BaudouinS/Granulobot-Design/PCB_Design/Factory_picture/T-I16W281433A（2）.jpg

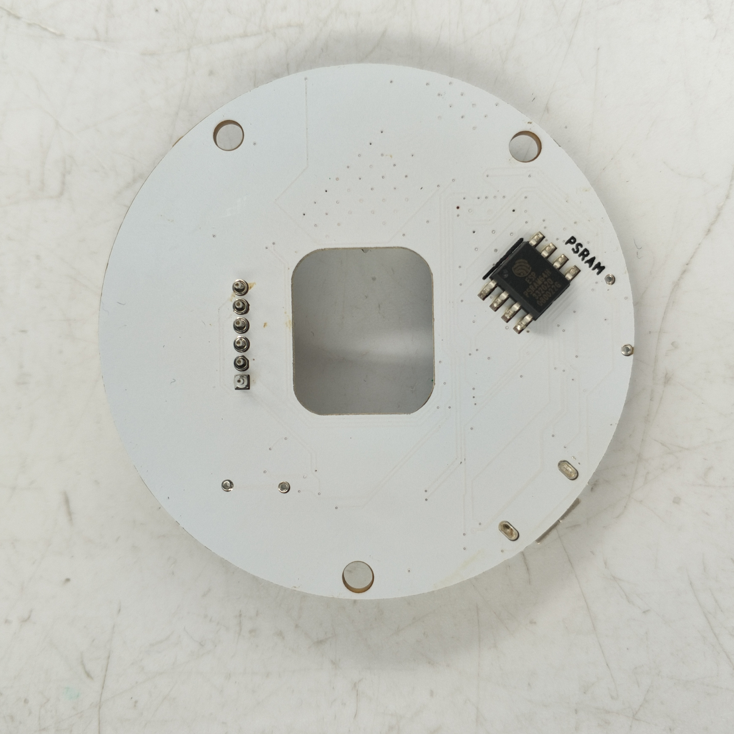
PCB_Design/Factory_picture/T-I16W281433A（2）.jpg
