BaudouinS/Granulobot-Design/PCB_Design/Factory_picture/T-I16W281433A（1）.jpg

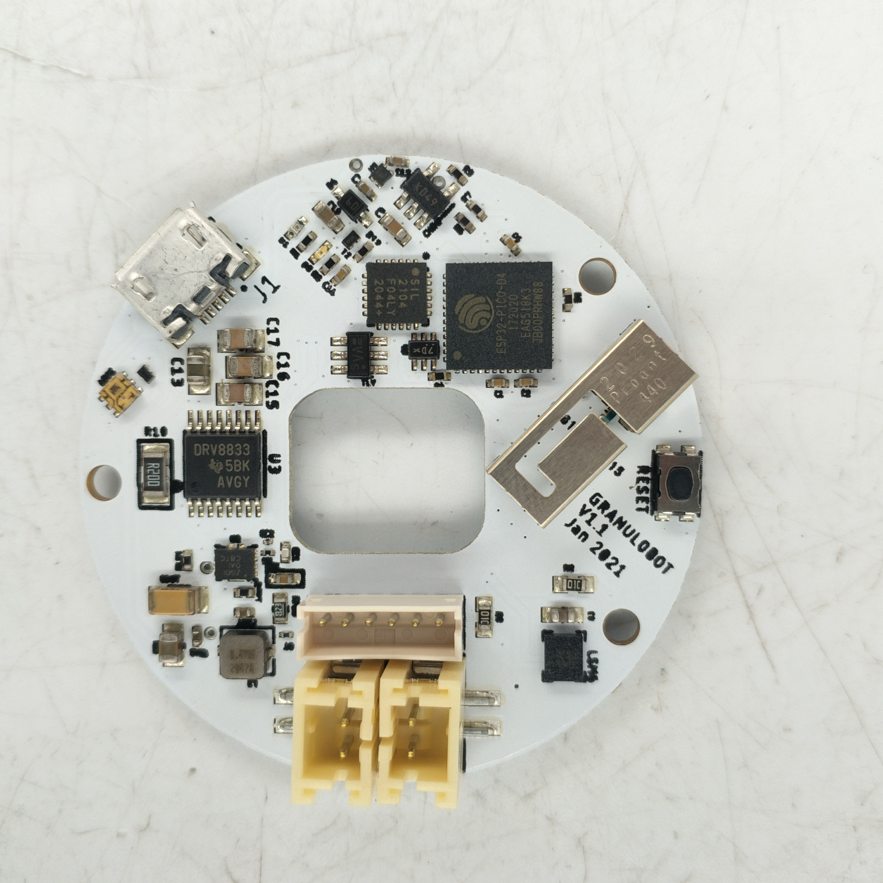
PCB_Design/Factory_picture/T-I16W281433A（1）.jpg
