BaudouinS/Granulobot-Design/PCB_Design/Copy of quotation-T-I14W281433A-W281433ASI13-10sets-Granulobot_BOM_V10_TOP 2021-1-12 _Reviewed.xls

10sets unite price | 10sets Total price | Note | Part | QTY | Manufacturer | Part Ref (manufacturer) | Package | Descritpion | Supplier | old name | Link
$0.053 | $2.100 |  | C1,C2,C6,C14 | 4 | MULTICOMP PRO | MC0402X104K250CT | 0402MP | Ceramic capacitor 0.1uF | Newark |  | https://www.newark.com/multicomp/mc0402x104k250ct/ceramic-capacitor-rohs-compliant/dp/06X6159?ost=06x6159
$0.210 | $4.200 |  | C3,C10 | 2 | SAMSUNG ELECTRO-MECHANICS | CL10A106KP8NNNC | 0603MP | Ceramic Capacitor 10UF | digikey |  | https://www.digikey.com/en/products/detail/samsung-electro-mechanics/CL10A106KP8NNNC/3886850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
$0.367 | $3.675 | 5-7work days | C4 | 1 | MURATA | GJM1555C1HR75BB01D | 0402MP | Ceramic Capacitor 0.75pF | digikey |  | https://www.digikey.com/en/products/detail/GJM1555C1HR75BB01D/490-8106-1-ND/4380393?itemSeq=347688887
$0.945 | $9.450 | 5-7work days | C5 | 1 | KEMET | C0402C159B5GACTU | 0402MP | Ceramic Capacitor 1.5pF | digikey |  | https://www.digikey.com/en/products/detail/kemet/C0402C159B5GACTU/3316947
$0.053 | $1.050 |  | C7,C12 | 2 | MURATA | GRT155R70J105KE01D | 0402MP | Ceramic capacitor 1uF | digikey |  | https://www.digikey.com/en/products/detail/GRT155R70J105KE01D/490-18216-1-ND/9867945?itemSeq=347689425
$0.053 | $0.525 |  | C8 | 1 | MULTICOMP PRO | MCSH18B104K250CT | 0603-NO | Ceramic capacitor 0.1uF | newark |  | https://www.newark.com/multicomp/mcsh18b104k250ct/ceramic-capacitor-rohs-compliant/dp/23T7348?ost=23t7348
$0.105 | $1.050 |  | C13 | 1 | TAIYO YUDEN | LMK212BJ106KG-T | 0805-NO | Ceramic Capacitor 10UF | digikey |  | https://www.digikey.com/en/products/detail/taiyo-yuden/LMK212BJ106KG-T/930652
$0.053 | $0.525 |  | C15 | 1 | MULTICOMP PRO | MCSH21B104K100CT | 0805-NO | Ceramic capacitor 0.1uF | newark |  | https://www.newark.com/multicomp/mcsh21b104k100ct/ceramic-capacitor-rohs-compliant/dp/23T7403?ost=23t7403
$0.210 | $4.200 |  | C16,C17 | 2 | YAGEO | CC0805KKX5R8BB106 | 0805-NO | Ceramic Capacitor 10UF | digikey |  | https://www.digikey.com/en/products/detail/yageo/CC0805KKX5R8BB106/5195275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
$0.053 | $0.525 |  | Cbst | 1 | MuRata | GRM155R71A104KA01D | 0402_ | Ceramic capacitor 0.1uF | digikey
$0.032 | $0.315 |  | Cc1 | 1 | MuRata | GRM1555C1H391JA01J | 0402_ | Ceramic capacitor 390pF | digikey
$0.630 | $6.300 | 5-7work days | Cc2 | 1 | TDK | C0402C0G1C180J020BC | 01005_ | Ceramic capacitor 18 pF | digikey
$0.210 | $2.100 | paramters is 22uF OK | Cin | 1 | MuRata | GRM21BR61A226ME44L | 0805_ | Ceramic capacitor 12uF | digikey
$0.053 | $0.525 |  | Cin2 | 1 | MuRata | GRM155R71C104KA88D | 0402_ | Ceramic capacitor 0.1uF | digikey
$0.525 | $5.250 |  | Cout | 1 | TDK | C3216X5R1E476M160AC | 1206_ | Ceramic capacitor 47 uF | digikey
$0.105 | $1.050 | out of stock, we suggest is GRM155R61A475MEAAD, is it OK? OK | Cvcc | 1 | MuRata | GRJ155R61A475ME1J | 0402_ | Ceramic capacitor 4.7 uF | Mouser
$0.032 | $0.630 |  | R1,R8 | 2 | PANASONIC | ERJ-2RKF2001X | _0402MP | RESISTOR 2K | digikey |  | https://www.digikey.com/en/products/detail/panasonic-electronic-components/ERJ-2RKF2001X/192194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
$0.032 | $0.630 | out of stock, we suggest is RC0603FR-0710KL, is it OK? OK | R2,R9 | 2 | NIC COMPONENTS | NRC-AS06F1002TRF | R0603 | RESISTOR 10K | newark |  | https://www.newark.com/nic-components/nrc-as06f1002trf/res-10k-1-0-1w-0603-thick-film/dp/52AH2942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
$0.032 | $0.315 |  | R3 | 1 | PANASONIC | ERJ-2RKF3301X | _0402MP | RESISTOR 3K3 | newark |  | https://www.newark.com/panasonic/erj-2rkf3301x/res-thick-film-3k3-1-0-1w-0402/dp/64R5278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
$0.032 | $0.315 |  | R4 | 1 | PANASONIC | ERJ-2RKF1002X | _0402MP | RESISTOR 10K | newark |  | https://www.newark.com/panasonic/erj-2rkf1002x/res-thick-film-10k-1-0-1w-0402/dp/64R5248?ost=erj-2rkf1002x
$0.032 | $0.630 |  | R5,R11 | 2 | MULTICOMP PRO | MCWR04X1003FTL | _0402MP | RESISTOR 100K | newark |  | https://www.newark.com/multicomp-pro/mcwr04x1003ftl/res-100k-1-62-5mw-0402-thick-film/dp/94X1105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
$0.032 | $0.315 |  | R6 | 1 | PANASONIC | ERJ-2RKF4423X | _0402MP | RESISTOR 442K | digikey |  | https://www.digikey.com/en/products/detail/panasonic-electronic-components/ERJ-2RKF4423X/192365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
$0.032 | $0.315 |  | R7 | 1 | VISHAY | CRCW0402160KFKED | _0402MP | RESISTOR 160K | newark |  | https://www.newark.com/vishay/crcw0402160kfked/res-thick-film-160k-1-0-063w-0402/dp/89M6611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
$0.525 | $5.250 | 5-7work days | R10 | 1 | OHMITE | KDV12FR200ET | _1206 | RESISTOR 0.2R 0.2ohm | newark |  | https://www.newark.com/ohmite/kdv12fr200et/0-2-ohm-1206-1-0-5w-rohs-compliant/dp/29AH2849?ost=kdv12fr200et
$0.032 | $0.315 |  | RC1 | 1 | Yageo | RC0201FR0723K7L | R0201 | RESISTOR 23.7k | digikey |  | https://www.digikey.com/en/products/detail/yageo/RC0201FR-0723K7L/5280384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
$0.032 | $0.315 |  | Rfbb | 1 | Yageo | RC0603FR-0782KL | R0603 | RESISTOR 82 k | digikey
$0.032 | $0.315 |  | Rfbt | 1 | Vishay-Dale | CRCW0402324KFKED | R0402 | RESISTOR 324 k | digikey
$0.032 | $0.315 |  | Rlim | 1 | Vishay-Dale | CRCW0402187KFKED | R0402 | RESISTOR 187 k | Mouser
$0.945 | $9.450 | 5-7work days | Rt | 1 | Vishay-Dale | CRCW020168K1FKED | R0201 | RESISTOR 68.1 k | Mouser
$0.840 | $8.400 | 5-7work days | D1 | 1 | WURTH ELEKTRONIK | 150040SS73220 | _0402 | LED red | digikey |  | https://www.digikey.com/en/products/detail/w%C3%BCrth-elektronik/150040SS73220/9857944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
$0.630 | $6.300 | 5-7work days | D2 | 1 | DIALIGHT | 5988A30107F | _0402 | LED Orange | digikey | D3 | https://www.digikey.com/en/products/detail/dialight/5988A30107F/10108964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
$0.210 | $2.100 |  | D3 | 1 | STMICROELECTRONICS | BAT60JFILM | SOD323_ST | Schottky barrier diode | eBay | D4
$7.665 | $7.665 | 3341 1pack-10pcs=$7.665 5-7work days | D4 | 1 | ADAFRUIT | _3341 | AP102-2020 | APA-102 RGB LED | digikey | LED1 | https://www.digikey.com/en/products/detail/adafruit-industries-llc/3341/6578337
$2.100 | $21.000 | 0402DC-7N5XGRW 5-7work days OK | L1 | 1 | COILCRAFT | 0402DC-7N5XGRW | 0402_N | INDUCTOR 7.5nH High Q at 2.4GHz (for Wifi antenna) | digikey |  | https://www.digikey.com/en/products/detail/coilcraft/0402DC-7N5XGRW/12714785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
$1.575 | $15.750 | 5-7work days | L2 | 1 | Vishay-Dale | IHLP1212AEERR47M11 |  | INDUCTOR 470nH DCR: 15 mΩ IDC: 6.7 A | digikey |  | https://www.digikey.com/en/products/detail/vishay-dale/IHLP1212AEERR47M11/2533925
$0.315 | $3.150 | 5-7work days | T1 | 1 | Nexperia | PDTA143TMB,315 | SOT883(B) | PNP general purpose transistors | Mouser | PDTA143TMB,315 | https://www.mouser.com/ProductDetail/Nexperia/PDTA143TMB315
$0.420 | $4.200 | 5-7work days | T2 | 1 | ON Semiconductor | NTNS3A65PZT5G | SOT883 | MOSFET P-CH 20V 281MA | digikey |  | https://www.digikey.com/en/products/detail/on-semiconductor/NTNS3A65PZT5G/4848843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
$0.210 | $2.100 |  | T3 | 1 | ON SEMICONDUCTOR | MUN5214DW1T1G | SOT-363 | DUAL NPN transistor SC70-6 | newark | Q3 | https://www.newark.com/on-semiconductor/mun5214dw1t1g/brt-transistor-50v-47k-10kohm/dp/10N9540
$0.525 | $5.250 | 5-7work days | U1 | 1 | ON SEMICONDUCTOR | NCP167BMX330TBG | 4-XDFN | LDO 700 MA ULTRA-LOW NOI | digikey |  | https://www.digikey.com/en/products/detail/on-semiconductor/NCP167BMX330TBG/9169761
$1.575 | $15.750 |  | U2 | 1 | Texas Instruments | TPS61089RNRR | VQFN | 12.6-V, 7-A Fully-Integrated Synchronous Boost Converters | Texas Instrument |  | https://www.ti.com/store/ti/en/p/product/?p=TPS61089RNRR
$1.050 | $10.500 |  | U3 | 1 | Texas Instruments | DRV8833PWPR | 16-HTSSOP | IC MOTOR DRIVER PAR 16HTSSOP | Texas Instrument |  | https://www.ti.com/store/ti/en/p/product/?p=DRV8833PWPR
$1.575 | $15.750 |  | U4 | 1 | SILICON LABS | CP2104-F03-GMR | 24QFN | USB TO SERIAL CONVERTER MICROBUILDER | digikey | IC2 | https://www.digikey.com/en/products/detail/CP2104-F03-GMR/336-4146-1-ND/7650425?itemSeq=346297763
$0.735 | $7.350 |  | CHRG | 1 | Microchip Technology | MCP73831T-2ACI/OT | SOT23-5 | IC BATT CNTL LI-ION 1CEL | digikey |  | https://www.digikey.com/en/products/detail/microchip-technology/MCP73831T-2ACI-OT/964301
$6.153 | $61.530 | 3-4work days OK | LSM6 | 1 | STMicroelectronics | LSM6DSOXTR | 14-VFLGA | INEMO INERTIAL MODULE: 3D ACCELE | Mouser | ISM330 | https://www.mouser.com/ProductDetail/511-LSM6DSOXTR
$4.200 | $42.000 |  | ESP32 | 1 | Espressif Systems | ESP32-PICO-D4 | QFN-48 | ESP32-PICO-D4 | Mouser | PICO-D4 | https://www.mouser.com/ProductDetail/Espressif-Systems/ESP32-PICO-D4/?qs=MLItCLRbWsw7MJlbN3HfdA%3D%3D
$1.785 | $17.850 | SUGGEST IS TLV493DA1B6HTSA2 5-7work days, is it OK? OK | TLV | 1 | Infineon Technologies | TLV493DA1B6HTSA2 | TSOP-6 | Board Mount Hall Effect / Magnetic Sensors | Mouser | TLV493D | https://www.mouser.com/ProductDetail/Infineon-Technologies/TLV493DA1B6HTSA2/
$0.525 | $5.250 |  | J1 | 1 | Amphenol ICC (FCI) | 10118193-0001LF |  | USB - micro B USB 2.0 Receptacle Connector 5 Position Surface Mount, Right Angle; Through Hole | digikey |  | https://www.digikey.com/en/products/detail/amphenol-icc-fci/10118193-0001LF/2785388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
$0.420 | $4.200 | 5-7work days | J2 | 1 | JST | B6B-ZR(LF)(SN) | ZR | ZR Series 1.5 mm Pitch 6 Position Through Hole Top Entry Shrouded Heade Check prices | digikey |  | https://www.digikey.com/en/products/detail/amphenol-icc-fci/10118193-0001LF/2785388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
$0.315 | $6.300 | we provide is B2B-PH-SM4-TB(LF)(SN), is it OK? OK | J3, J4 | 2 | JST | B2B-PH-SM4-TB(LF)(SN) | PH | B2B-PH-SM4-TB | newark | LIPO-CON-1,LIPO-CON-2 | https://www.newark.com/jst-japan-solderless-terminals/b2b-ph-sm4-tb-lf-sn/wire-to-board-connector-header/dp/37K9941
$0.840 | $8.400 | 7-10work days | KMR2 | 1 | C & K COMPONENTS | KMR241NG ULC LFS | BTN_KMR2_4.6X2.8 | Push button (Reset ) | newark |  | https://www.newark.com/c-k-components/kmr241ng-ulc-lfs/tact/dp/35AH0932?st=kmr241ng
$0.892 | $8.925 | 5-7work days | ANT | 1 | Proant AB | PRO-OB-440 |  | RF ANT 2.4GHZ STAMPED MET SLD | digikey |  | https://www.digikey.com/en/products/detail/proant-ab/PRO-OB-440/4895679?s=N4IgTCBcDaIA4CcD2BaJAjFAWLAGEAugL5A
$1.575 | $15.750 |  | PSRAM | 1 | espressif | ESP-PSRAM64H | SOP8 | Extra memory - facultative -64M Bits Serial Pseudo-SRAM with SPI and QPI | eBay
 | $357.420 | component price
 | $88.000 | assembly price | Total Items | 62
 | $130.000 | board price
