BaudouinS/Granulobot-Design/Mechanical_Design/Passive_Rotor_V20_M15.STL

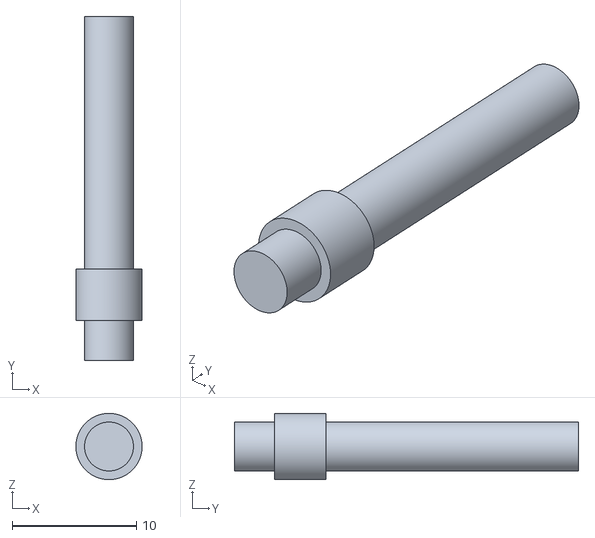
[picture p3: CAD file, 2023-03-20]
Mechanical_Design/Passive_Rotor_V20_M15.STL
5.33 x 27.7 x 5.33
