BaudouinS/Granulobot-Design/PCB_Design/Granulobot_V9_top.dxf

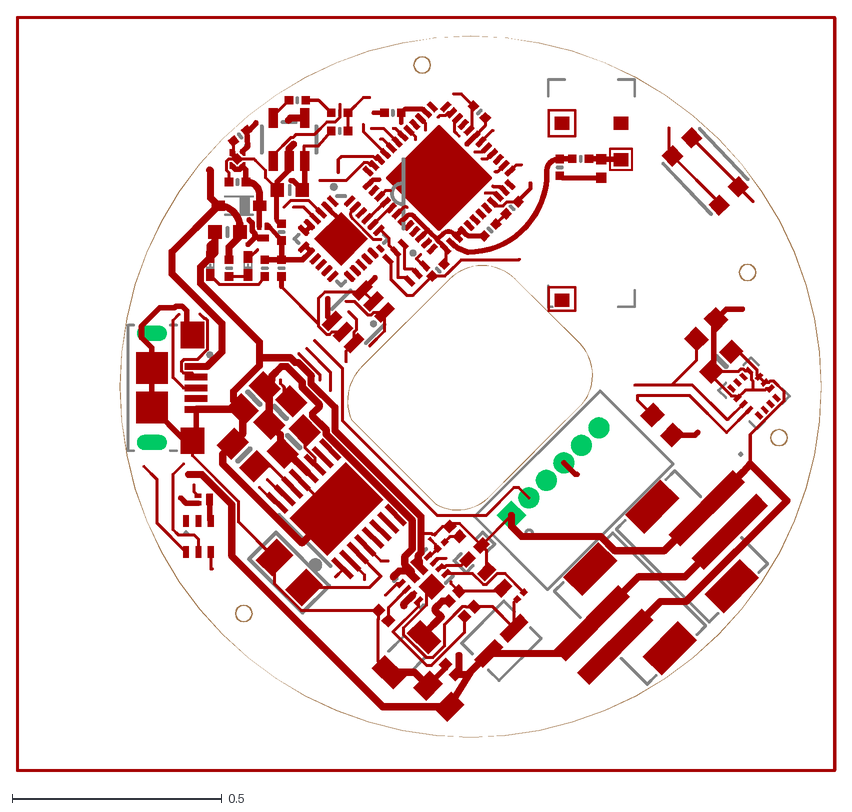
[picture p4: CAD file, 2023-02-26]
PCB_Design/Granulobot_V9_top.dxf
1.95 x 1.80
