BaudouinS/Granulobot-Design/Mechanical_Design/Bearing_lower_centering_V20.STL

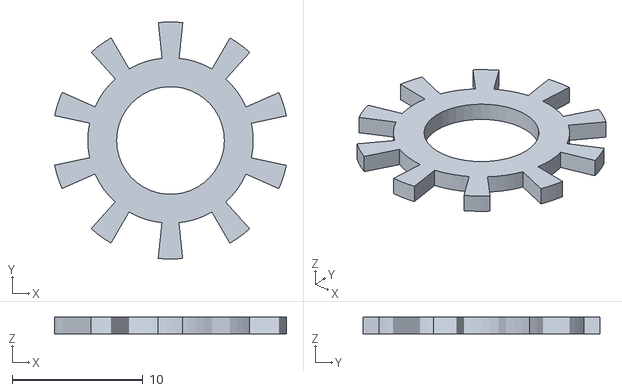
[picture p5: CAD file, 2023-03-20]
Mechanical_Design/Bearing_lower_centering_V20.STL
17.8 x 18.2 x 1.27
