BaudouinS/Granulobot-Design/Mechanical_Design/Balls_Holder_12slots_V20.STL

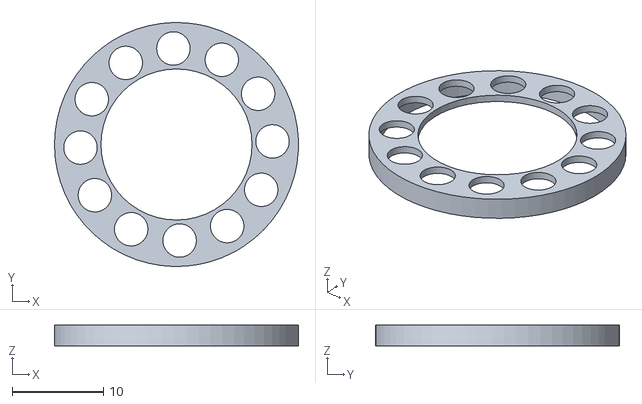
[picture p6: CAD file, 2023-03-20]
Mechanical_Design/Balls_Holder_12slots_V20.STL
26.7 x 26.7 x 2.29
