BaudouinS/Granulobot-Design/Mechanical_Design/Active_Rotor_V20_upperwheel.STL

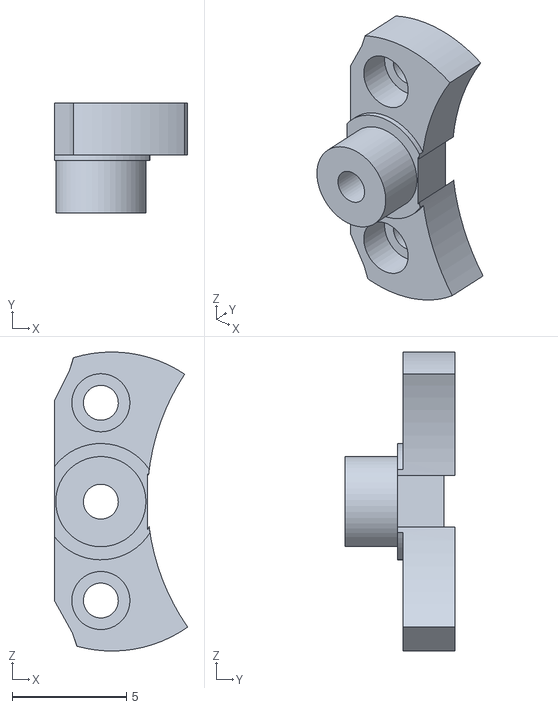
[picture p7: CAD file, 2023-03-20]
Mechanical_Design/Active_Rotor_V20_upperwheel.STL
5.82 x 4.80 x 13.1
