BaudouinS/Granulobot-Design/Mechanical_Design/Battery_Holder_V20_2Batt.STL

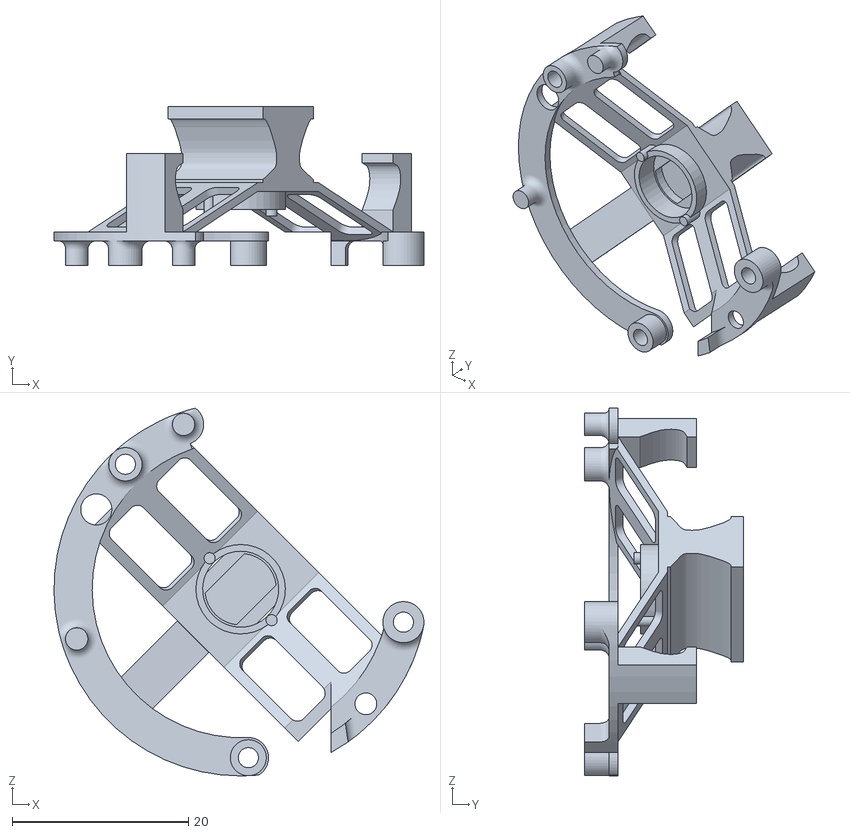
[picture p8: CAD file, 2023-03-20]
Mechanical_Design/Battery_Holder_V20_2Batt.STL
42.0 x 18.0 x 41.8
