BaudouinS/Granulobot-Design/Mechanical_Design/adjustment_ring_V20.STL

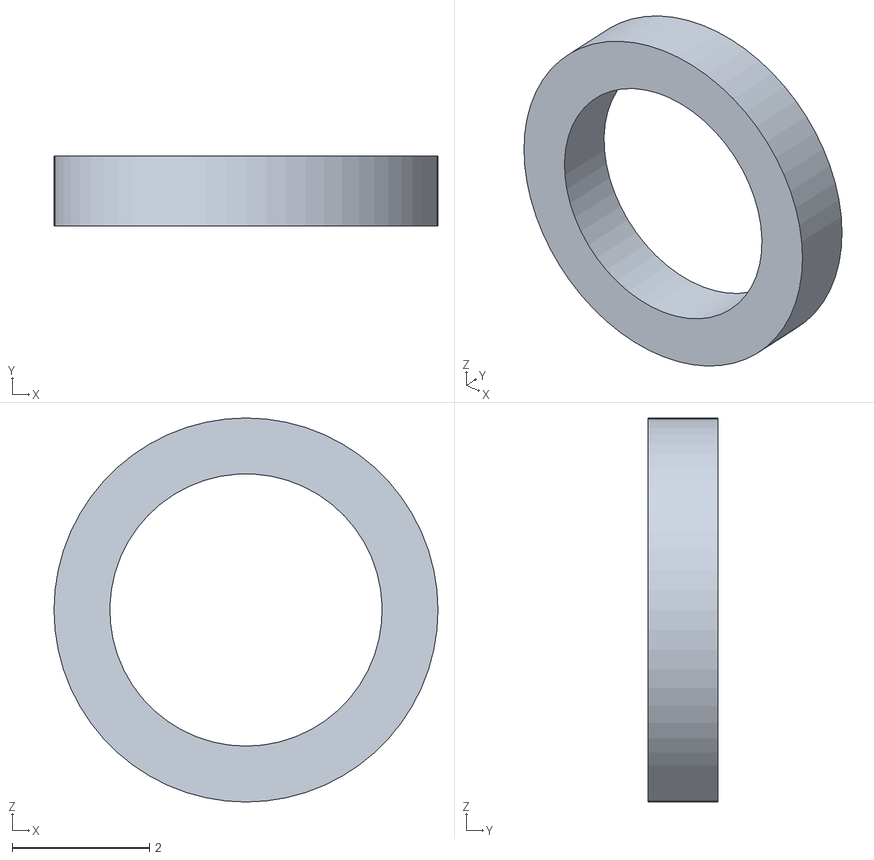
[picture p9: CAD file, 2023-03-20]
Mechanical_Design/adjustment_ring_V20.STL
5.59 x 1.02 x 5.59
