BaudouinS/Granulobot-Design/Mechanical_Design/MagnetRod_sleeve_V20_M15.STL

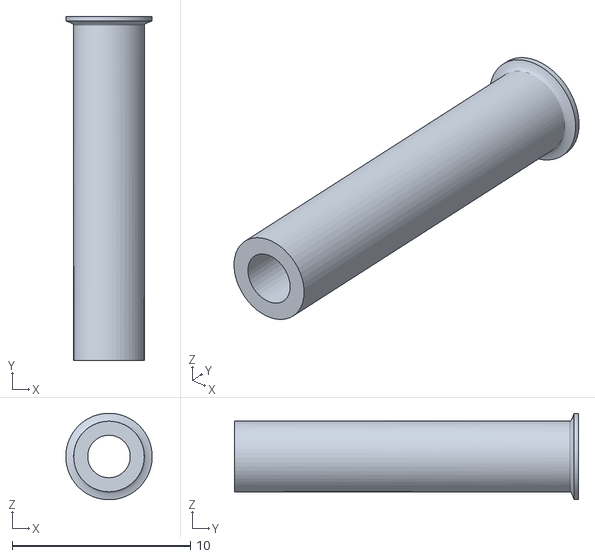
[picture p10: CAD file, 2023-03-20]
Mechanical_Design/MagnetRod_sleeve_V20_M15.STL
4.85 x 19.3 x 4.85
