BaudouinS/Granulobot-Design/Mechanical_Design/Bearing-attach-V20_4.STL

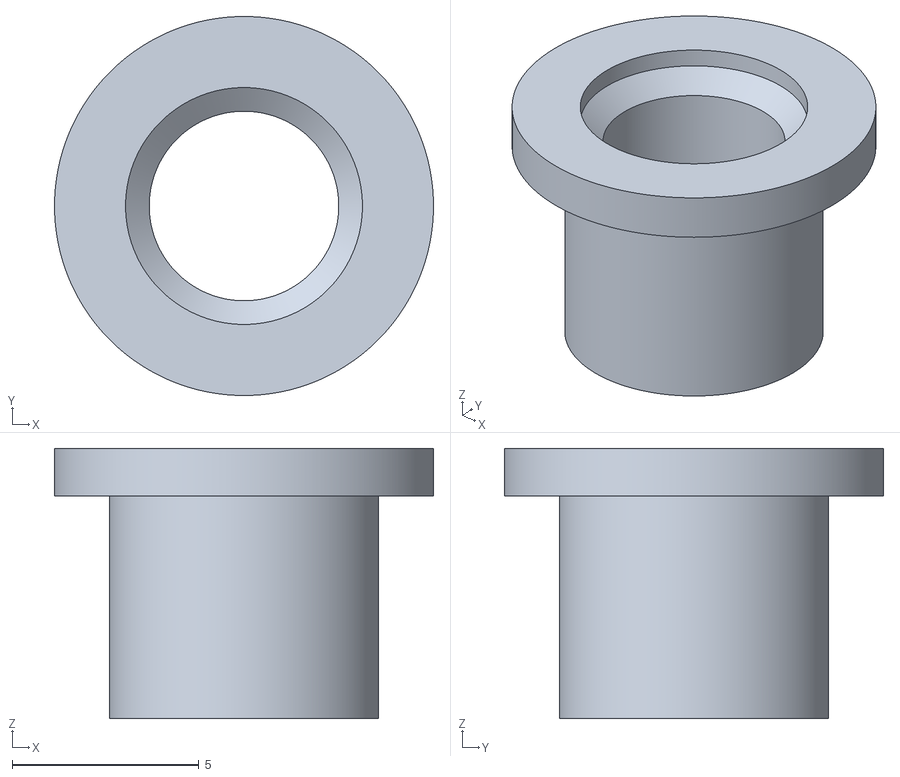
[picture p11: CAD file, 2023-03-20]
Mechanical_Design/Bearing-attach-V20_4.STL
10.2 x 10.2 x 7.24
