BaudouinS/Granulobot-Design/Mechanical_Design/Lower-Motor_gear_V20_gear-wave_1.STL

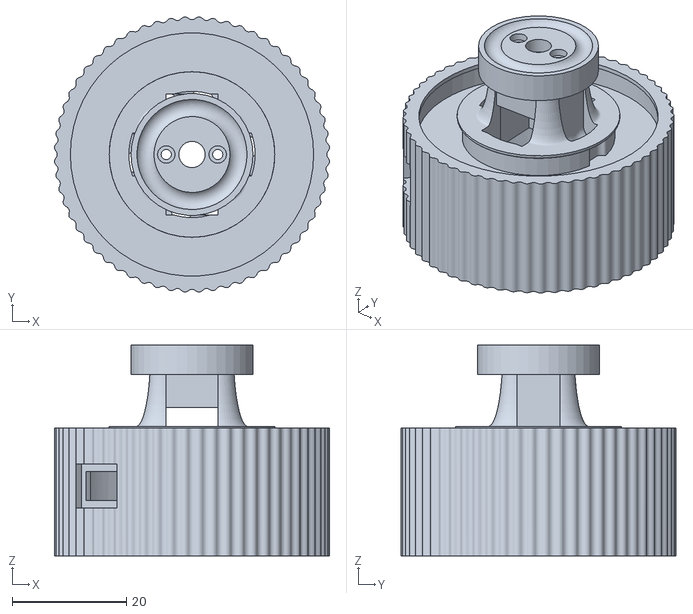
[picture p12: CAD file, 2023-03-20]
Mechanical_Design/Lower-Motor_gear_V20_gear-wave_1.STL
48.1 x 48.1 x 36.8
