BaudouinS/Granulobot-Design/Mechanical_Design/Nut_ShaftTightScrew_V20.STL

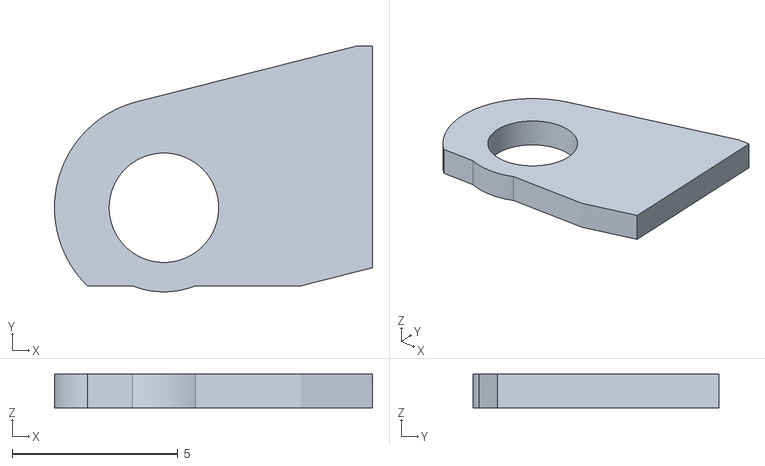
[picture p13: CAD file, 2023-03-20]
Mechanical_Design/Nut_ShaftTightScrew_V20.STL
9.60 x 7.42 x 1.02
