BaudouinS/Granulobot-Design/PCB_Design/Granulobot_V10.brd

## EAGLE design PCB_Design/Granulobot_V10.brd (2023-02-26)

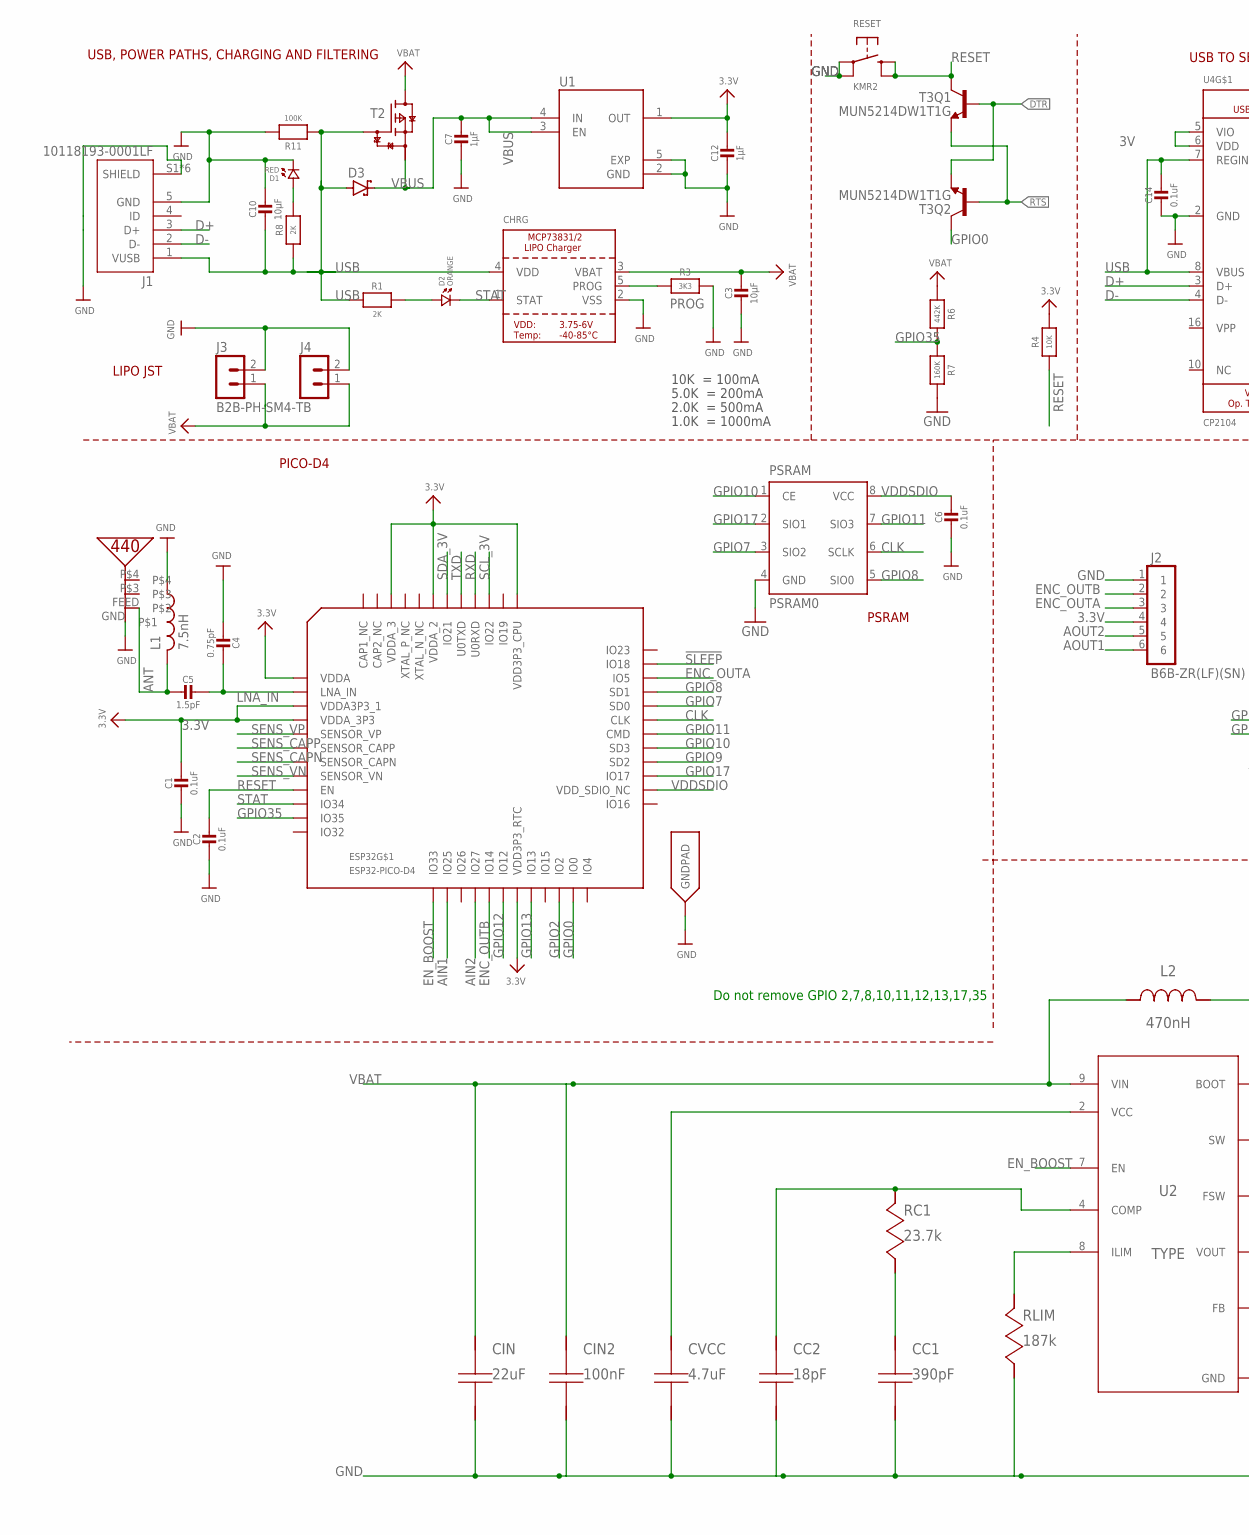
[picture p14: schematic Granulobot_V10.sch, part in row 1, column 1]

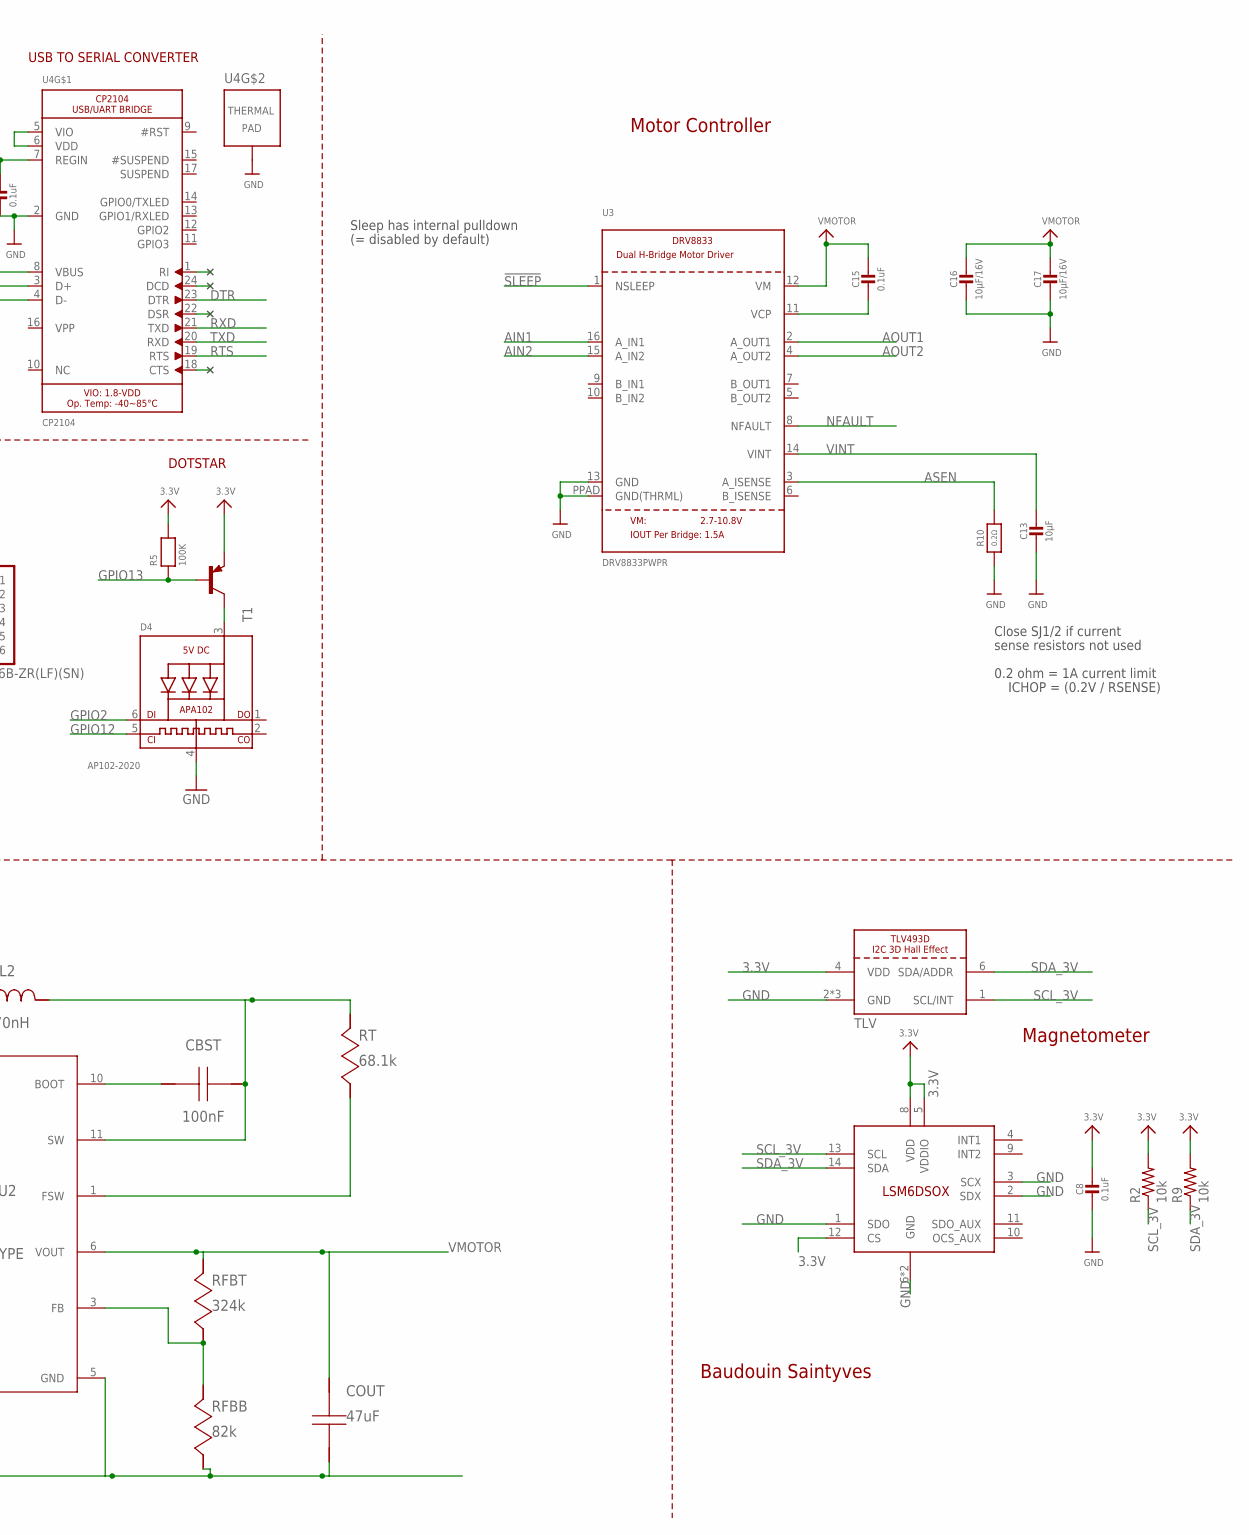
[picture p15: schematic Granulobot_V10.sch, part in row 1, column 2]

Parts:
ANT: PRO-OB-440
C1, C2, C6, C14: 0.1uF; _0402MP; MPN MC0402X104K250CT
C3, C10: 10µF; _0603MP; MPN CL10A106KP8NNNC
C4: 0.75pF; _0402MP; MPN GJM1555C1HR75BB01D
C5: 1.5pF; _0402MP; MPN C1005C0G1H1R5B050BA
C7, C12: 1µF; _0402MP; MPN GRT155R70J105KE01D.
C8: 0.1uF; 0603-NO; MPN MCSH18B104K250CT
C13: 10µF; 0805-NO; MPN LMK212BJ106KG-T
C15: 0.1uF; 0805-NO; MPN MCSH21B104K100CT
C16, C17: 10µF/16V; 0805-NO; MPN CC0805KKX5R8BB106
CBST: 100nF; 0402; MPN MC0402X104K250CT
CC1: 390pF; 0402; MPN MC0402B391K250CT
CC2: 18pF; 01005; MPN GRM0225C1E180GA02L
CHRG: TP4065-4.2V-SOT25-R; SOT23-5
CIN: 22uF; 0805; MPN C1210C224J3GACTU
CIN2: 100nF; 0402; MPN MC0402X104K250CT
COUT: 47uF; 1206; MPN C0603C474K4PACTU
CVCC: 4.7uF; 0402_065; MPN JMK105BBJ475MV-F
D1: RED; 0402.LED; MPN 150040SS73220
D2: ORANGE; 0402.LED; MPN 5988A30107F
D3: BAT60J; SOD323_ST; MPN BAT60JFILM
D4: AP102-2020; MICROBUILDER_APA102_2020
ESP32: ESP32-PICO-D4; PICO-D4-QFN48
J1: 10118193-0001LF; FCI_10118193-0001LF
J2: B6B-ZR(LF)(SN); JST_B6B-ZR(LF)(SN)
J3, J4: B2B-PH-SM4-TB; MPN B2B-PH-SM4-TB(LF)(SN)
L1: 7.5nH; RESC0402_N; MPN ELJ-QF7N5JF
L2: 470nH; IHLP-1212AE; MPN IHLP1212AEERR47M11
LSM6: LSM6DSOX; LGA-14L
PSRAM: PSRAM0; SOP8
R1, R8: 2K; _0402MP; MPN ERJ-2RKF2001X
R2, R9: 10k; R0603; MPN NRC-AS06F1002TRF
R3: 3K3; _0402MP; MPN ERJ-2RKF3301X
R4: 10K; _0402MP; MPN ERJ-2RKF1002X
R5, R11: 100K; _0402MP; MPN MCWR04X1003FTL
R6: 442K; _0402MP; MPN ERJ-2RKF4423X
R7: 160K; _0402MP; MPN CRCW0402160KFKED
R10: 0.2Ω; _1206; MPN KDV12FR200ET
RC1: 23.7k; 0201
RESET: KMR2; BTN_KMR2_4.6X2.8; MPN KMR231G LFS
RFBB: 82k; 0603; MPN NRC-AS06F8202TRF
RFBT: 324k; 0402; MPN ERJ-2RKF3243X
RLIM: 187k; 0402; MPN ERJ-2RKF1873X
RT: 68.1k; 0201; MPN RC0201FR-0768K1L
T1: TINYPICO-PNPAMB; SOT883(B)
T2: TINYPICO-P-FETKMB; SOT883(B)
T3: MUN5214DW1T1G; DUAL_NPN_SC70-6; MPN MUN5214DW1T1G
TLV: TLV493D; SOT23-6; MPN TLV493DA1B6HTSA2
U1: NCP170AMX300TCG; VREG_NCP170AMX300TCG; MPN NCP170AMX300TCG
U2: Value; RNR0011A
U3: DRV8833PWPR; HTSSOP16; MPN DRV8833PWPR
U4: CP2104; MICROBUILDER_QFN24_4MM_SMSC; MPN CP2104-F03-GMR

Connections:
3.3V: C1.1, C8.1, C12.1, ESP32.1 (VDDA), ESP32.3 (VDDA3P3_1), ESP32.4 (VDDA_3P3), ESP32.19 (VDD3P3_RTC), ESP32.37 (VDD3P3_CPU), ESP32.43 (VDDA_2), ESP32.46 (VDDA_3), J2.4, LSM6.5 (VDDIO), LSM6.8 (VDD), LSM6.12 (CS), R2.2, R4.2, R5.2, R9.2, T1.2 (E), TLV.4 (VDD), U1.1 (OUT)
3V: U4.5 (VIO), U4.6 (VDD)
!SLEEP: ESP32.35 (IO18), U3.1 (NSLEEP)
AIN1: ESP32.14 (IO25), U3.16 (A_IN1)
AIN2: ESP32.16 (IO27), U3.15 (A_IN2)
ANT: ANT.FEED, C5.2, L1.2
AOUT1: J2.6, U3.2 (A_OUT1)
AOUT2: J2.5, U3.4 (A_OUT2)
ASEN: R10.2, U3.3 (A_ISENSE)
CLK: ESP32.31 (CLK), PSRAM.6 (SCLK)
D+: J1.3 (D+), U4.3 (D+)
D-: J1.2 (D-), U4.4 (D-)
DTR: T3.1 (E), T3.5 (B), U4.23 (DTR)
ENC_OUTA: ESP32.34 (IO5), J2.3
ENC_OUTB: ESP32.17 (IO14), J2.2
EN_BOOST: ESP32.13 (IO33), U2.7 (EN)
GND: ANT.GND, C1.2, C2.2, C3.2, C4.2, C6.2, C7.2, C8.2, C10.1, C12.2, C13.2, C14.2, C16.2, C17.2, CC1.2, CC2.2, CHRG.2 (VSS), CIN.2, CIN2.2, COUT.2, CVCC.2, D1.P$2 (2), D4.4 (GND), ESP32.EXP (GNDPAD), J1.5 (GND), J1.S1 (SHIELD), J1.S2 (SHIELD), J1.S3 (SHIELD), J1.S4 (SHIELD), J1.S5 (SHIELD), J1.S6 (SHIELD), J2.1, J3.2, J4.2, L1.1, LSM6.1 (SDO), LSM6.2 (SDX), LSM6.3 (SCX), LSM6.6 (GND), LSM6.7 (GND), PSRAM.4 (GND), R3.2, R7.2, R10.1, R11.2, RESET.A, RESET.A' (P1), RFBB.2, RLIM.2, TLV.2 (GND), TLV.3 (GND), TLV.5 (GND), U1.2 (GND), U1.5 (EXP), U2.5 (GND), U3.13 (GND), U3.PPAD (GND(THRML)), U4.2 (GND), U4.THERM (TP)
GPIO0: ESP32.23 (IO0), T3.6 (C)
GPIO2: D4.6 (DI), ESP32.22 (IO2)
GPIO7: ESP32.32 (SD0), PSRAM.3 (SIO2)
GPIO8: ESP32.33 (SD1), PSRAM.5 (SIO0)
GPIO9: ESP32.28 (SD2)
GPIO10: ESP32.29 (SD3), PSRAM.1 (CE)
GPIO11: ESP32.30 (CMD), PSRAM.7 (SIO3)
GPIO12: D4.5 (CKI), ESP32.18 (IO12)
GPIO13: ESP32.20 (IO13), R5.1, T1.1 (B)
GPIO17: ESP32.27 (IO17), PSRAM.2 (SIO1)
GPIO35: ESP32.11 (IO35), R6.2, R7.1
LNA_IN: C4.1, C5.1, ESP32.2 (LNA_IN)
unnamed: D1.P$1 (1), R8.2
unnamed: D2.P$1 (1), R1.2
unnamed: D4.3 (VDD), T1.3 (C)
unnamed: C15.2, U3.11 (VCP)
unnamed: RFBB.1, RFBT.2, U2.3 (FB)
unnamed: RLIM.1, U2.8 (ILIM)
unnamed: CBST.1, U2.10 (BOOT)
unnamed: CBST.2, L2.2, RT.1, U2.11 (SW)
unnamed: CVCC.1, U2.2 (VCC)
unnamed: CC1.1, RC1.2
unnamed: CC2.1, RC1.1, U2.4 (COMP)
unnamed: RT.2, U2.1 (FSW)
NFAULT: U3.8 (NFAULT)
PROG: CHRG.5 (PROG), R3.1
RESET: C2.1, ESP32.9 (EN), R4.1, RESET.B (S), RESET.B' (S1), T3.3 (C)
RTS: T3.2 (B), T3.4 (E), U4.19 (RTS)
RXD: ESP32.40 (U0RXD), U4.21 (TXD)
SCL_3V: ESP32.39 (IO22), LSM6.13 (SCL), R2.1, TLV.1 (SCL/INT)
SDA_3V: ESP32.42 (IO21), LSM6.14 (SDA), R9.1, TLV.6 (SDA/ADDR)
SENS_CAPN: ESP32.7 (SENSOR_CAPN)
SENS_CAPP: ESP32.6 (SENSOR_CAPP)
SENS_VN: ESP32.8 (SENSOR_VN)
SENS_VP: ESP32.5 (SENSOR_VP)
STAT: CHRG.1 (STAT), D2.P$2 (2), ESP32.10 (IO34)
TXD: ESP32.41 (U0TXD), U4.20 (RXD)
USB: C10.2, C14.1, CHRG.4 (VDD), D3.A, J1.1 (VUSB), R1.1, R8.1, R11.1, T2.1 (G), U4.7 (REGIN), U4.8 (VBUS)
VBAT: C3.1, CHRG.3 (VBAT), CIN.1, CIN2.1, J3.1, J4.1, L2.1, R6.1, T2.3 (D), U2.9 (VIN)
VBUS: C7.1, D3.C, T2.2 (S), U1.3 (EN), U1.4 (IN)
VDDSDIO: C6.1, ESP32.26 (VDD_SDIO_NC), PSRAM.8 (VCC)
VINT: C13.1, U3.14 (VINT)
VMOTOR: C15.1, C16.1, C17.1, COUT.1, RFBT.1, U2.6 (VOUT), U3.12 (VM)

Notes on the sheet:
USB, POWER PATHS, CHARGING AND FILTERING
USB TO SERIAL CONVERTER
PICO-D4
10K = 100mA
5.0K = 200mA
2.0K = 500mA
1.0K = 1000mA
PSRAM
DOTSTAR
Close SJ1/2 if current
sense resistors not used
0.2 ohm = 1A current limit
ICHOP = (0.2V / RSENSE)
Sleep has internal pulldown
(= disabled by default)
Motor Controller
Magnetometer
LIPO JST
Do not remove GPIO 2,7,8,10,11,12,13,17,35
Baudouin Saintyves

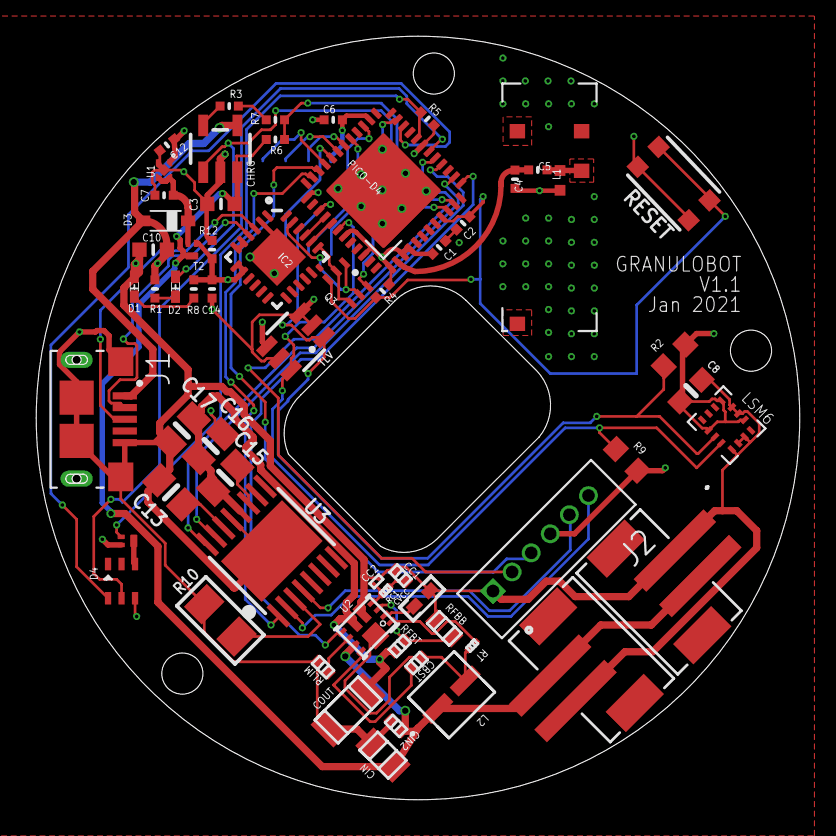
[picture p16: board Granulobot_V10.brd from above]

Board: 4 copper layers, 42.4 x 42.4 mm, 62 parts (1 on the bottom side), 54 nets.
