BaudouinS/Granulobot-Design/(commit log)

2023-02-26 Create repository with V18
    old version, V21 to come
    [10118193-0001LF--3DModel-STEP-56544.STEP, 545348 assembly.STEP, APA102-2020 MODEL v15.step, Active_Rotor_ForIntegration_V18.SLDPRT, Active_Rotor_V18_upperwheel.SLDPRT, Assembly_V18 - Active_Rotor_V18_upperwheel-1.STL, Assembly_V18 - Balls_Holder_12slots_V18-1.STL, Assembly_V18 - Bearing-attach-V18-1.STL]
2023-03-20 Most Recent STL files
    [10118193-0001LF--3DModel-STEP-56544.STEP, 545348 assembly.STEP, APA102-2020 MODEL v15.step, Active_Rotor_ForIntegration_V18.SLDPRT, Active_Rotor_V18_upperwheel.SLDPRT, Active_Rotor_V20_upperwheel.STL, Assembly_V18 - Active_Rotor_V18_upperwheel-1.STL, Assembly_V18 - Balls_Holder_12slots_V18-1.STL]
